grow-pro-org/pod-controller/kicad/pod-controller.kicad_pcb

## KiCad design kicad/pod-controller.kicad_pcb (2022-03-21)

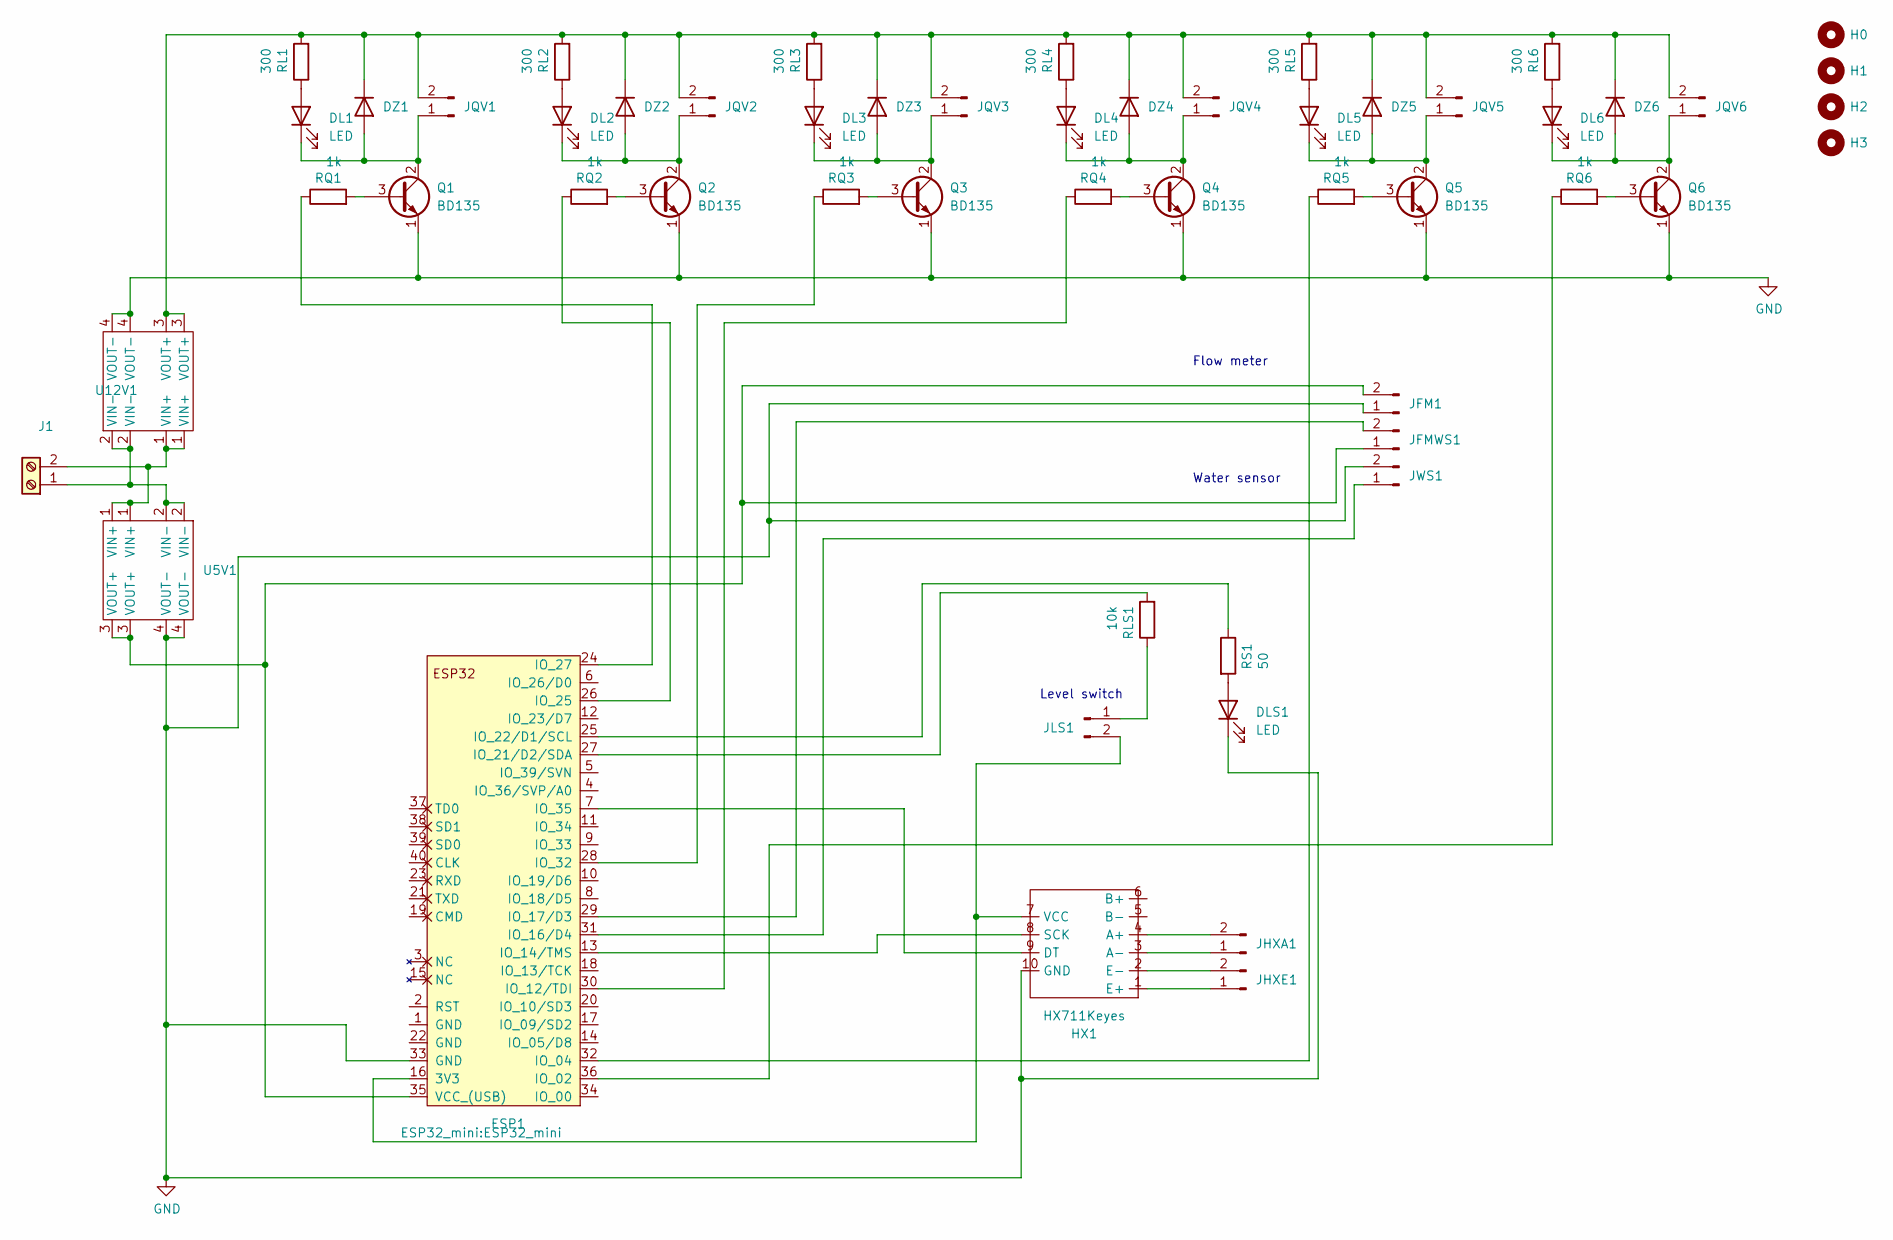
[picture p1: schematic pod-controller.kicad_sch]

Parts:
DL1, DL2, DL3, DL4, DL5, DL6: LED; D_1206_3216Metric
DLS1: LED; D_1206_3216Metric
DZ1, DZ2, DZ3, DZ4, DZ5, DZ6: 1N914; D_SMA
ESP1: mini_esp32; ESP32_mini
H0, H1, H2, H3: MountingHole; MountingHole_2.2mm_M2
HX1: HX711Keyes; HX711
J1: Screw_Terminal_01x02; TerminalBlock_bornier-2_P5.08mm
JFM1: Conn_01x02_Male; JST_EH_B2B-EH-A_1x02_P2.50mm_Vertical
JFMWS1: Conn_01x02_Male; JST_EH_B2B-EH-A_1x02_P2.50mm_Vertical
JHXA1: Conn_01x02_Male; JST_EH_B2B-EH-A_1x02_P2.50mm_Vertical
JHXE1: Conn_01x02_Male; JST_EH_B2B-EH-A_1x02_P2.50mm_Vertical
JLS1: Conn_01x02_Male; JST_EH_B2B-EH-A_1x02_P2.50mm_Vertical
JQV1, JQV2, JQV3, JQV4, JQV5, JQV6: Conn_01x02_Male; JST_EH_B2B-EH-A_1x02_P2.50mm_Vertical
JWS1: Conn_01x02_Male; JST_EH_B2B-EH-A_1x02_P2.50mm_Vertical
Q1, Q2, Q3, Q4, Q5, Q6: BD135; TO-126-3_Vertical
RL1, RL2, RL3, RL4, RL5, RL6: 300; R_0805_2012Metric
RLS1: 10k; R_0805_2012Metric
RQ1, RQ2, RQ3, RQ4, RQ5, RQ6: 1k; R_0805_2012Metric
RS1: 50; R_0805_2012Metric
U5V1, U12V1: MPT1584EN; SRT_MPT1584EN_Module

Connections:
GND: DLS1.1 (K), ESP1.33 (GND), HX1.10 (GND), JFM1.1, JWS1.2, Q1.1 (E), Q2.1 (E), Q3.1 (E), Q4.1 (E), Q5.1 (E), Q6.1 (E), U5V1.4 (VOUT-), U12V1.4 (VOUT-)
unnamed: DL1.1 (K), DZ1.2 (A), JQV1.1, Q1.2 (C)
unnamed: DL1.2 (A), RL1.1
unnamed: DL2.1 (K), DZ2.2 (A), JQV2.1, Q2.2 (C)
unnamed: DL2.2 (A), RL2.1
unnamed: DL3.1 (K), DZ3.2 (A), JQV3.1, Q3.2 (C)
unnamed: DL3.2 (A), RL3.1
unnamed: DL4.1 (K), DZ4.2 (A), JQV4.1, Q4.2 (C)
unnamed: DL4.2 (A), RL4.1
unnamed: DL5.1 (K), DZ5.2 (A), JQV5.1, Q5.2 (C)
unnamed: DL5.2 (A), RL5.1
unnamed: DL6.1 (K), DZ6.2 (A), JQV6.1, Q6.2 (C)
unnamed: DL6.2 (A), RL6.1
unnamed: DLS1.2 (A), RS1.2
unnamed: DZ1.1 (K), DZ2.1 (K), DZ3.1 (K), DZ4.1 (K), DZ5.1 (K), DZ6.1 (K), JQV1.2, JQV2.2, JQV3.2, JQV4.2, JQV5.2, JQV6.2, RL1.2, RL2.2, RL3.2, RL4.2, RL5.2, RL6.2, U12V1.3 (VOUT+)
unnamed: ESP1.7 (IO_35), HX1.9 (DT)
unnamed: ESP1.13 (IO_14/TMS), HX1.8 (SCK)
unnamed: ESP1.16 (3V3), HX1.7 (VCC), JLS1.2
unnamed: ESP1.24 (IO_27), RQ1.1
unnamed: ESP1.25 (IO_22/D1/SCL), RS1.1
unnamed: ESP1.26 (IO_25), RQ2.1
unnamed: ESP1.27 (IO_21/D2/SDA), RLS1.2
unnamed: ESP1.28 (IO_32), RQ3.1
unnamed: ESP1.29 (IO_17/D3), JFMWS1.2
unnamed: ESP1.30 (IO_12/TDI), RQ4.1
unnamed: ESP1.31 (IO_16/D4), JWS1.1
unnamed: ESP1.32 (IO_04), RQ5.1
unnamed: ESP1.35 (VCC_(USB)), JFM1.2, JFMWS1.1, U5V1.3 (VOUT+)
unnamed: ESP1.36 (IO_02), RQ6.1
unnamed: HX1.1 (E+), JHXE1.1
unnamed: HX1.2 (E-), JHXE1.2
unnamed: HX1.3 (A-), JHXA1.1
unnamed: HX1.4 (A+), JHXA1.2
unnamed: J1.1, U5V1.2 (VIN-), U12V1.2 (VIN-)
unnamed: J1.2, U5V1.1 (VIN+), U12V1.1 (VIN+)
unnamed: JLS1.1, RLS1.1
unnamed: Q1.3 (B), RQ1.2
unnamed: Q2.3 (B), RQ2.2
unnamed: Q3.3 (B), RQ3.2
unnamed: Q4.3 (B), RQ4.2
unnamed: Q5.3 (B), RQ5.2
unnamed: Q6.3 (B), RQ6.2

Notes on the sheet:
Flow meter
Level switch
Water sensor

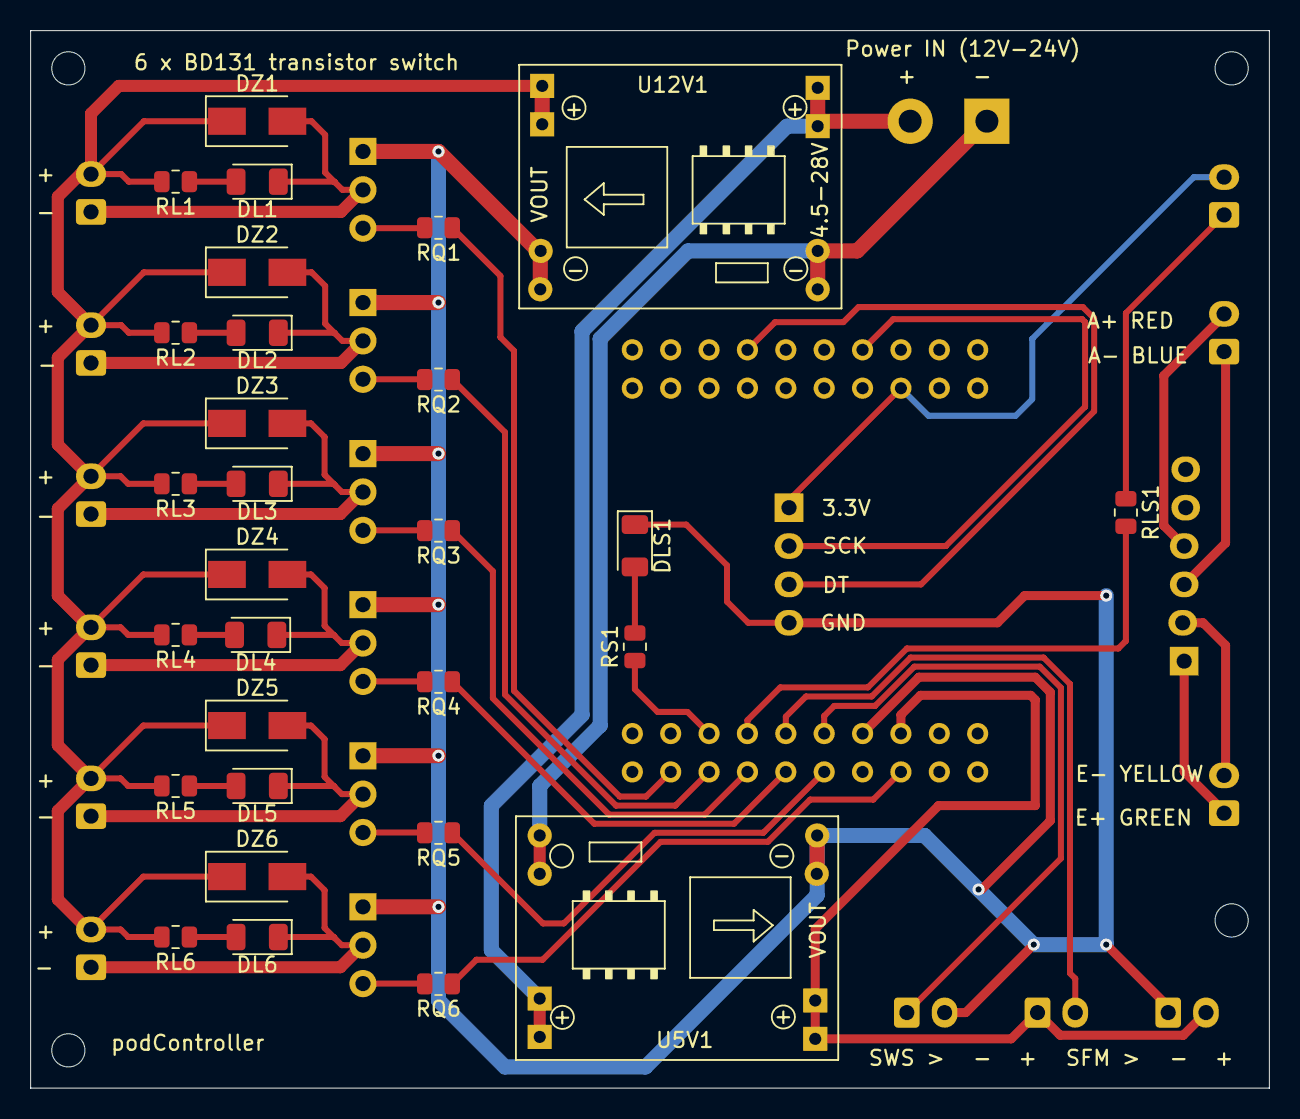
[picture p2: board pod-controller.kicad_pcb from above]

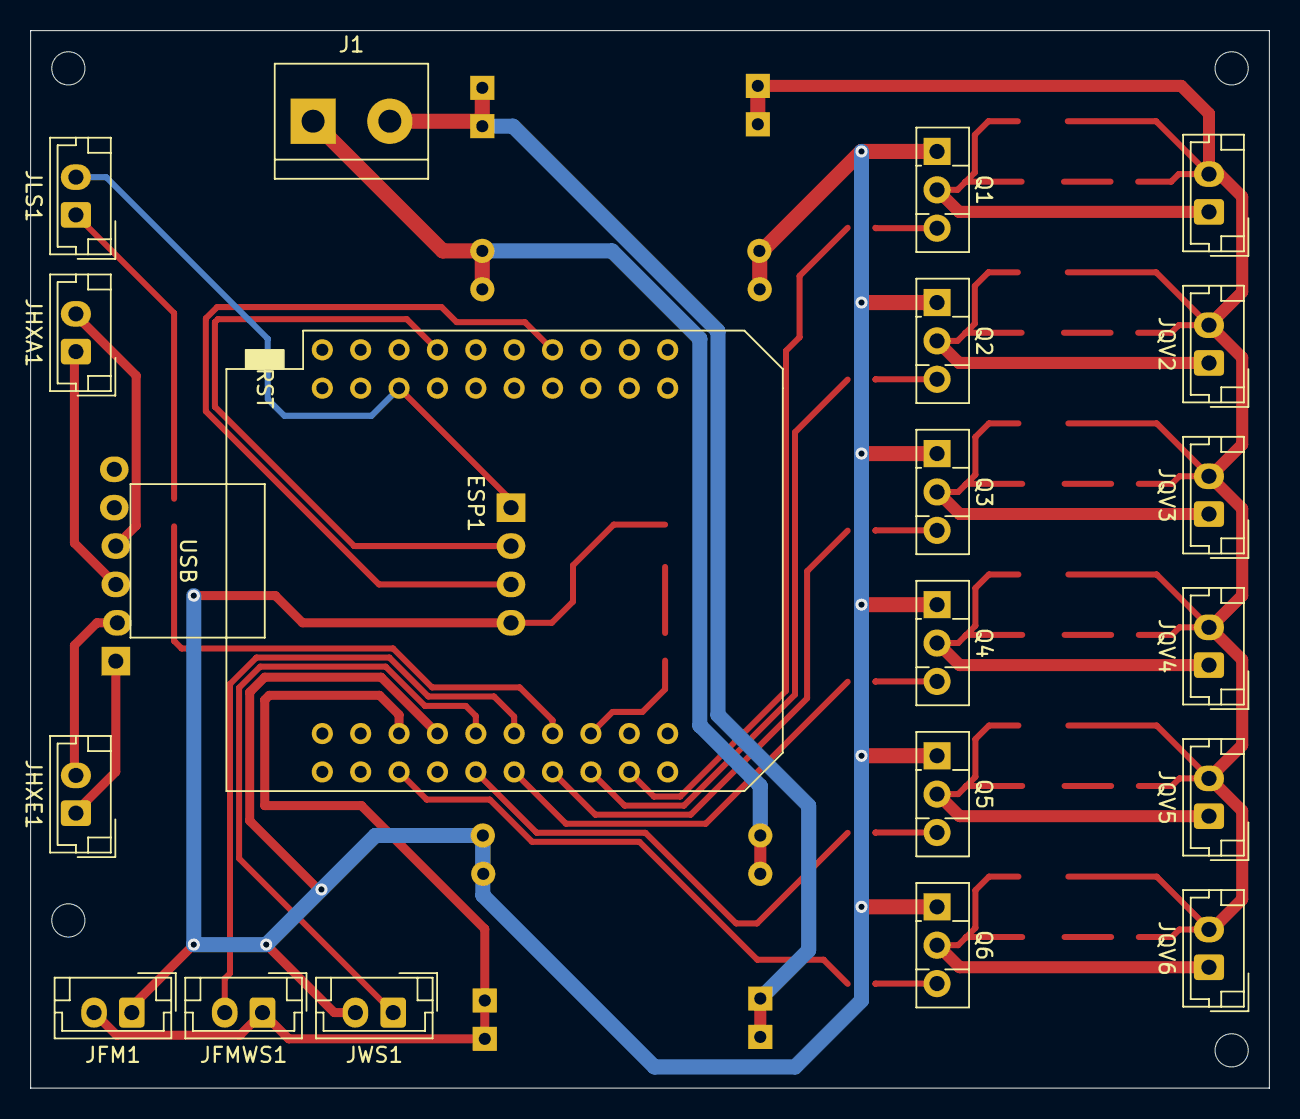
[picture p3: board pod-controller.kicad_pcb from below]

Board: 2 copper layers, 82.0 x 70.0 mm, 54 parts (20 on the bottom side), 42 nets.
