grow-pro-org/pod-controller/(threads)

Thread 1 (2022-04-10):

Input voltage should not be 5V!

grow-pro-org, 2022-04-10:
Currently the input for the level sensor is bound to 5V. Correct this to use 3.3V.
This issue costs about 10 esp32

Thread 2 (2022-04-10):

Problem with power supply and ground when connect the esp with usb

grow-pro-org, 2022-04-10:
When the esp32 is connected to the board and external power supply is on a usb plugin leads to esp32 crash!
